5inf/uprog2/hw/housing/variant a/uprog2 Housing.png

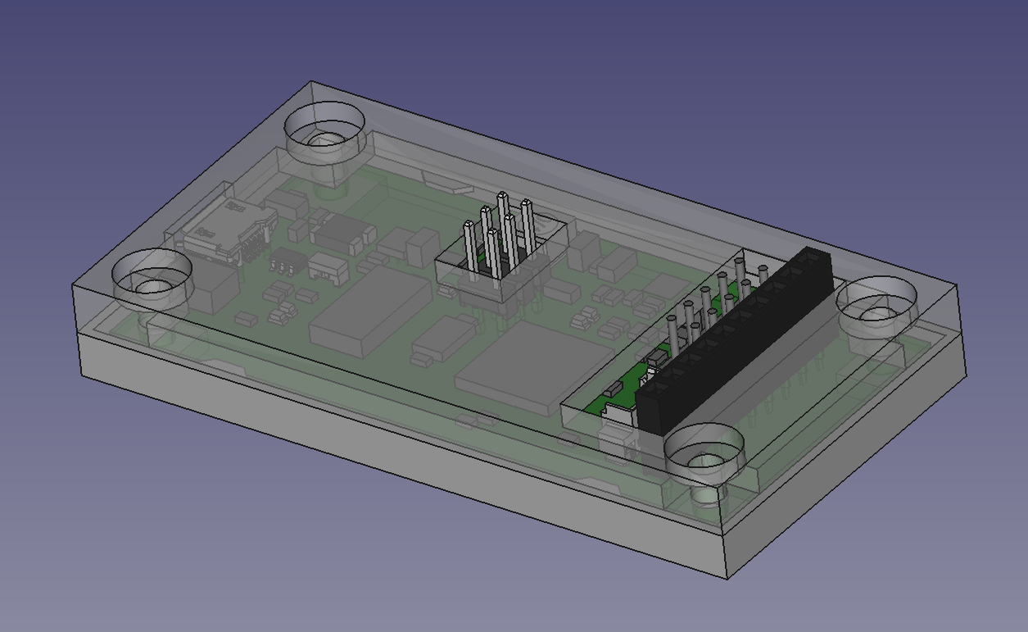
hw/housing/variant a/uprog2 Housing.png
