5inf/uprog2/hw/pcb/BOM.xlsx

uprog2.PrjPCB
BoardRevisionDate |  | 2019-02-20
BoardRevisionNumber |  | 0.0.0
# | Designator | Value | Description | Footprint | Quantity | Manufacturer | ManufacturerPartNumber
1 | C1, C8, C10 | X7R 25V 10% 100nF | CAP CER 1608[0603] X7R 10% 25V 100nF | Cap CER 1608[0603]L | 3 | not specifie | not specified
2 | C4, C5, C9 | X5R 50V 10% 1µF | CAP CER 1608[0603] X5R 10% 50V 1µF | Cap CER 1608[0603]L | 3 | not specified | not specified
3 | C12, C13 | C0G 25V 10% 15pF | CAP CER 1608[0603] C0G 10% 25V 15pF | Cap CER 1608[0603]L | 2 | not specified | not specified
4 | C14 | X7R 50V 10% 100nF | CAP CER 3216[1206] X7R 10% 50V 100nF | Cap CER 3216[1206]L | 1 | not specified | not specified
5 | D1 | 12A 5.0V | TVS Diode WE-TVS-HS, VRWM=5V | SOT23_5L | 1 | Würth | WE-TVS 824011
6 | D2 | 1mA 24V |  | SMB DO214AA | 1 | Bourns | SMBJ24CA
7 | D3, D5 | 500mA 40V |  | SOD123 | 2 | On Semi | MBR0540T1G
8 | F1 | 0.2A 30V | Polymeric PTC Resettable Fuse 30V 200mA Ih Surface Mount 1812 (4532 Metric), Concave | Fuse 4532[1812] | 1 | Littlefuse | 1812L020PR
9 | J1 | Molex PicoBlade 53398-0471 | 1.25mm Pitch PicoBlade™ Header, Surface Mount, Vertical, 4 Circuits | Connector 1.25mm 1x4 180° Molex PicoBlade 53398-0471 | 1 | Molex | 53398-0471
10 | JP3 | Multicomp Header - | Connector 2.54mm 2x3 180° Multicomp Header - | Connector 2.54mm 2x3 180° Multicomp Header - | 1 | Multicomp | -
11 | L1 | 18nH 2A 2A | SMD EMI Suppression Ferrite Beads WE-CBF, Z= 300 Ohm | 1608[0603]N | 1 | Würth | 742792641
12 | L2 | 90Z 370mA 370mA | SMD Common Mode Noise Suppressor WE-CNSW, Z= 90 Ohm | WE-CNSW, 1206 | 1 | Würth | 744232090
13 | LED1, LED4 | green 2.0V 20mA | LED 1608[0603] 180° green 2.0V 20mA Liteon LTST-C190KGKT | LED 1608[0603] 180° | 2 | Liteon | LTST-C190KGKT
14 | LED2, LED6 | red 2.0V 20mA | LED 1608[0603] 180° red 2.0V 20mA Liteon LTST-C190KRKT | LED 1608[0603] 180° | 2 | Liteon | LTST-C190KRKT
15 | LED3, LED5 | orange 2.0V 20mA | LED 1608[0603] 180° orange 2.0V 20mA Liteon LTST-C190KFKT | LED 1608[0603] 180° | 2 | Liteon | LTST-C190KFKT
16 | Q2 | MMBF5485 | N-channel RF Amplifier | SOT23_N | 1 | ON Semi | MMBF5485
17 | Q4 | IRLML6402 | P-channel MOSFET, 65mOhm, -20V DS, 12V GS, 2.5Vop | SOT23_M | 1 | Infineon | IRLML6402
18 | R4, R14, R18 | 1% 75V 10k | Res R 1608[0603] 1% 75V 100mW 10k | Res1608[0603]L | 3 | not specified | not specified
19 | R5, R6, R7, R8, R15, R16, R21 | 1% 75V 1k | Res R 1608[0603] 1% 75V 100mW 1k | Res1608[0603]L | 7 | not specified | not specified
20 | R12 | 5% 75V 4.7k | Res R 1608[0603] 5% 75V 100mW 4.7k | Res1608[0603]L | 1 | not specified | not specified
21 | R17 | 5% 75V 4.7 | Res R 1608[0603] 5% 75V 100mW 4.7 | Res1608[0603]L | 1 | not specified | not specified
22 | R19, R20 | 5% 75V 2.2k | Res R 1608[0603] 5% 75V 100mW 2.2k | Res1608[0603]L | 2 | not specified | not specified
23 | R22 | 20% 75V 1M | Res R 1608[0603] 20% 75V 100mW 1M | Res1608[0603]L | 1 | not specified | not specified
24 | U1 | FT232RL | FT232R USB UART IC , SSOP-28, Reel | SSOP-28_N | 1 | FTDI | FT232RL
25 | U2 | ATMEGA644P-20AU | IC ATMEGA644P-20AU | TQFP44A_N | 1 | Microchip | ATMEGA644P-20AU
26 | U3 | LP38691SD-3.3NOPB | Linearregler 3,3V 500mA | WSON-N6 | 1 | TI | LP38691SD-3.3NOPB
27 | X2 | Würth Micro USB 2.0 Typ B 629 105136 821 | Connector Xmm 1x1 90° Würth Micro USB 2.0 Typ B 629 105136 821 | Connector Xmm 1x1 90° Würth Micro USB 2.0 Typ B 629 105136 821 | 1 | Würth | 629 105136 821
28 | Y1 | ABM3B-20.000MHZ-B2-T | ABM3B-20.000MHZ-B2-T - Quarz, 20 MHz, SMD, 5mm x 3.2mm, 50 ppm, 18 pF, 20 ppm, Baureihe ABM3B | Y5.0x3.2 | 1 | Abracon | ABM3B-20.000MHZ-B2-T
