5inf/uprog2/hw/housing/variant a/uprog2 Housing bottom.step

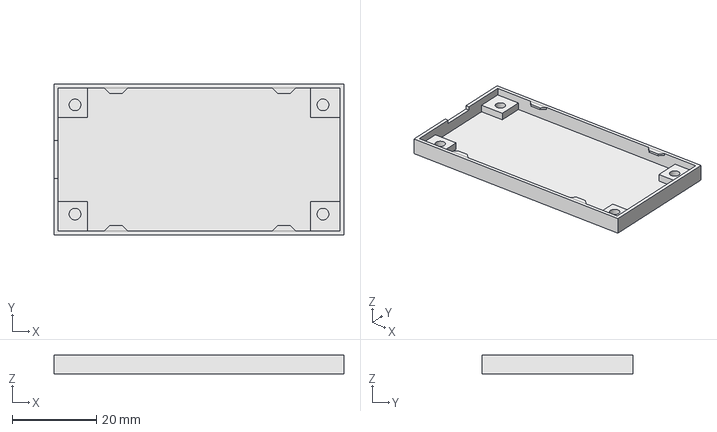
[picture p8: CAD file, 2019-07-19]
hw/housing/variant a/uprog2 Housing bottom.step
69.0 x 36.0 x 4.50 mm
