5inf/uprog2/hw/housing/variant b/uprog2.FCStd

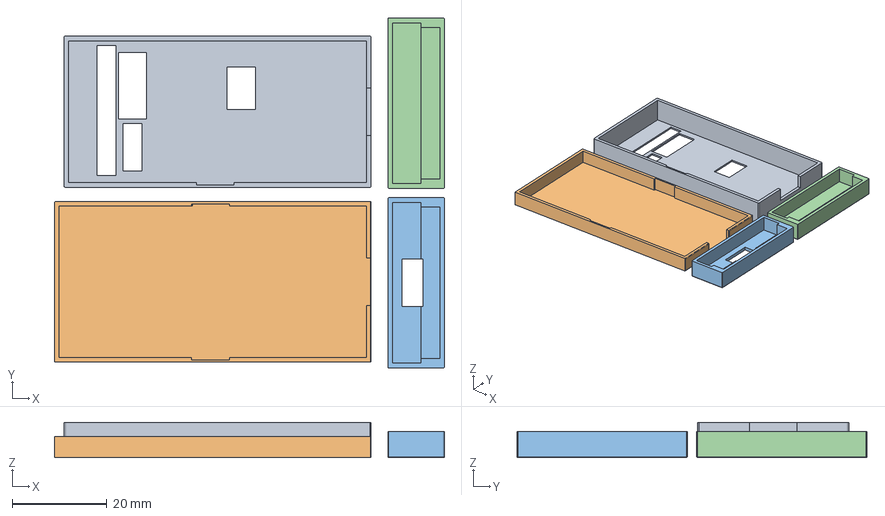
[picture p9: CAD file, 2019-07-22]
hw/housing/variant b/uprog2.FCStd
82.5 x 74.0 x 7.50 mm
