5inf/uprog2/hw/housing/variant a/uprog2 Housing top.step

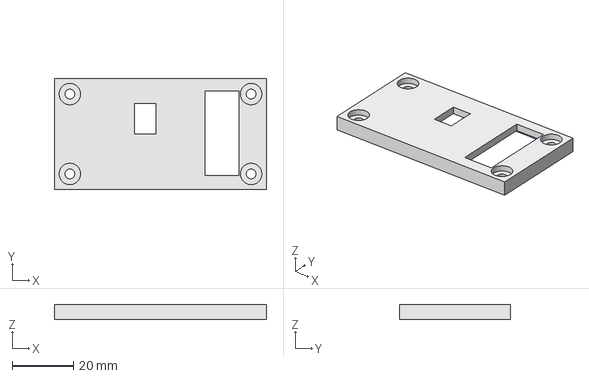
[picture p10: CAD file, 2019-07-19]
hw/housing/variant a/uprog2 Housing top.step
69.0 x 36.0 x 5.00 mm
