5inf/uprog2/(list of files, cad)

Other CAD files:
hw/housing/variant a/uprog2 Housing bottom.stl
hw/housing/variant a/uprog2 Housing top.stl
hw/housing/variant b/uprog2.stl
