5inf/uprog2/hw/pcb/uprog2.pdf

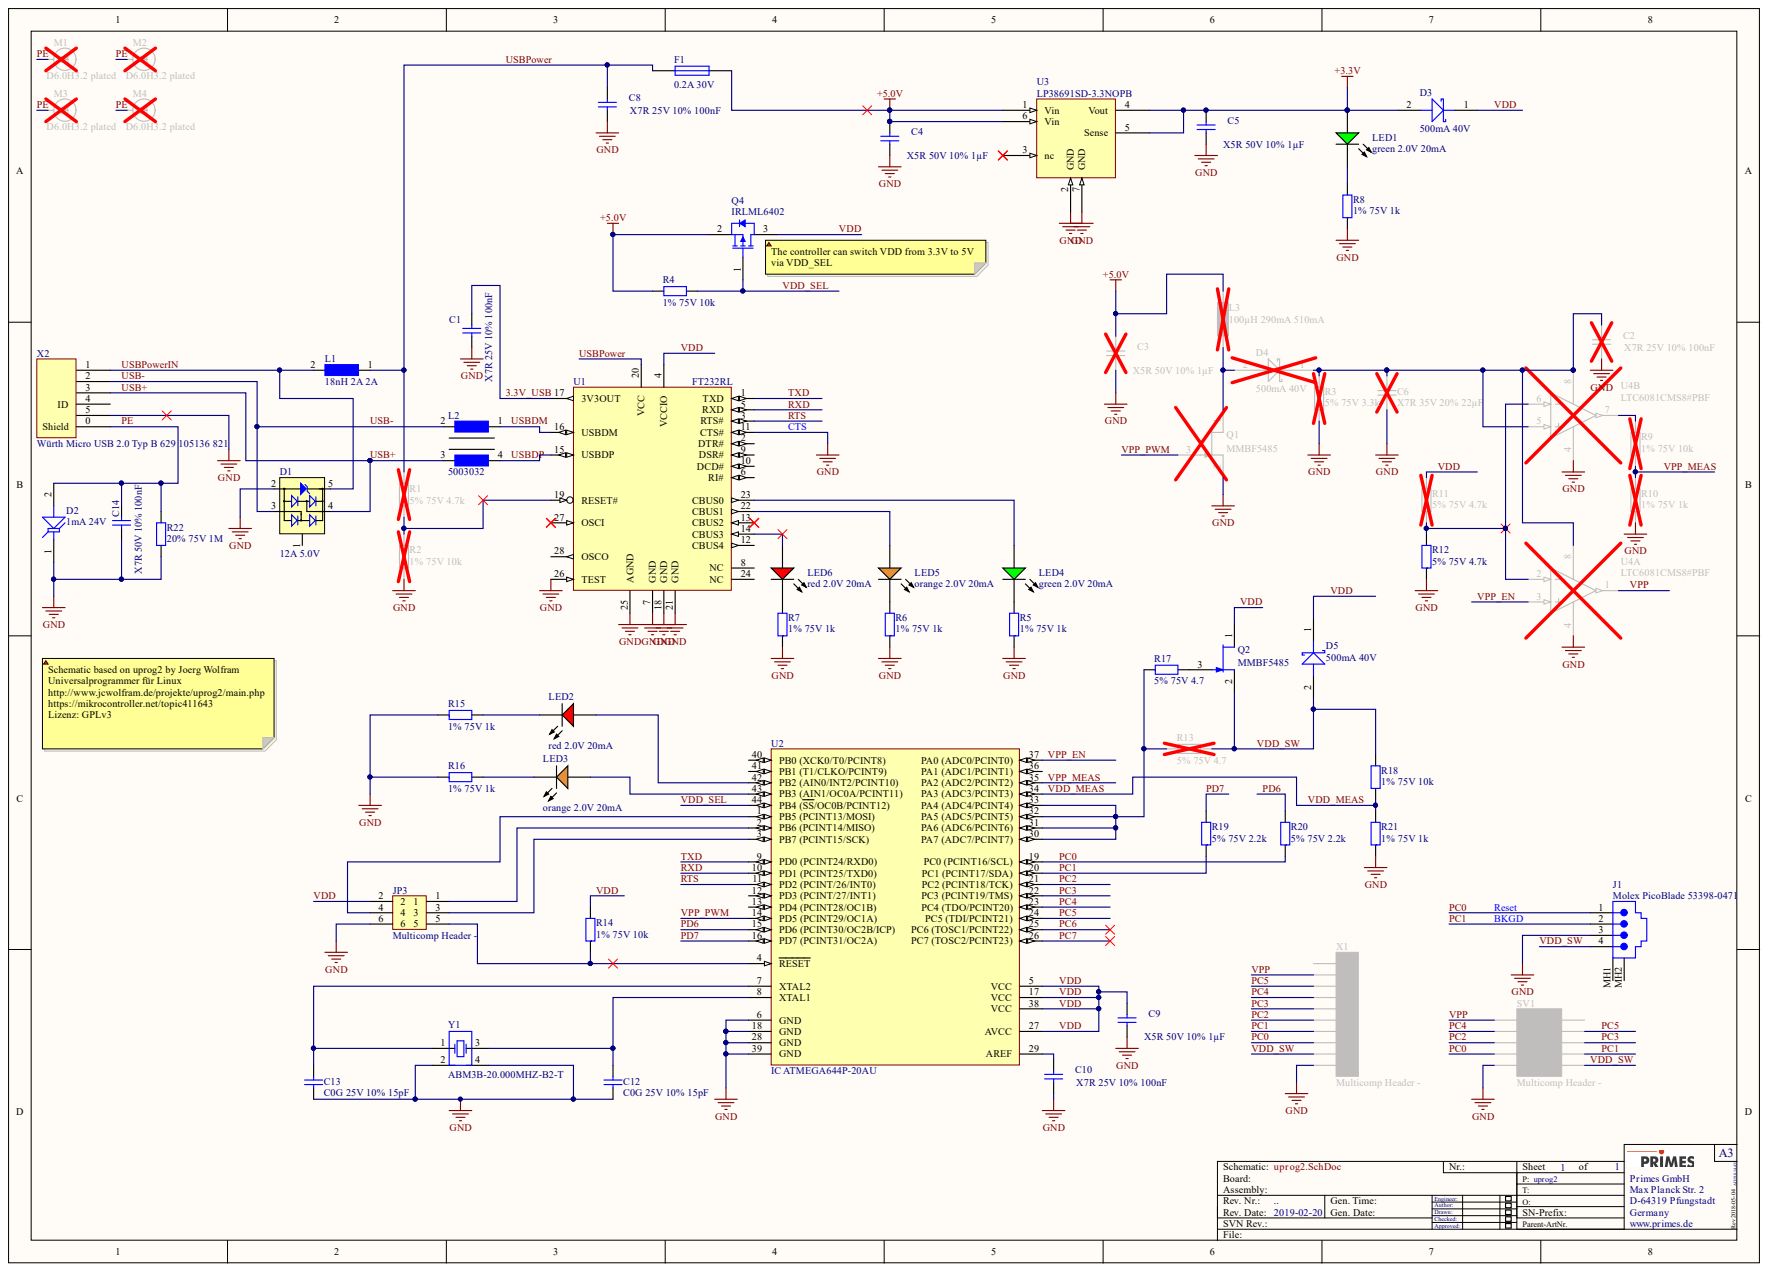
[picture p11: page 1]

The controller can switch VDD from 3.3V to 5V
via VDD_SEL

Würth Micro USB 2.0 Typ B 629 105136 821

Schematic based on uprog2 by Joerg Wolfram
Universalprogrammer für Linux
http://www.jcwolfram.de/projekte/uprog2/main.php
https://mikrocontroller.net/topic411643
Lizenz: GPLv3
