5inf/uprog2/(commit log)

2019-07-19 initial commit based on v1.33.
    [BOM.xlsx, uprog2 Housing bottom.step, uprog2 Housing top.step]
2019-07-19 Update README.md to include supported devices.
2019-07-19 Add second, improved variant of housing.
    [uprog2 Housing bottom.step, uprog2 Housing top.step, uprog2.FCStd, uprog2.stl]
2019-07-19 add STF files for housing and add gitignore.
    [uprog2 Housing bottom.stl, uprog2 Housing top.stl, uprog2.FCStd]
2019-07-20 Document fix for avra assembler.
2019-07-22 Add cutout for J1
    [uprog2.FCStd, uprog2.stl]
2019-10-29 Change USB VID and PID. Return correct error codes on exit.
    [main.c]
2022-10-06 Correct fuse values in Readme
2022-10-07 Update Readme.md for working with 1.42
    Working assembly for the adapter device.
    More details concerning changing the FTDI device PID and VID.
2022-10-07 Readme: Add verify to uprog2 device programming
