5inf/uprog2/(notices)

Notices in the files:
source/HOST/src/algorithm/algo_stm32f3.c:
copyright (c) 2012-2022 Joerg Wolfram (joerg@jcwolfram.de)
source/HOST/src/algorithm/algo_spiflash.c:
copyright (c) 2012-2020 Joerg Wolfram (joerg@jcwolfram.de)
source/HOST/src/main.c:
copyright (c) 2010-2022 Joerg Wolfram (joerg@jcwolfram.de)
source/HOST/src/algorithm/algo_rl78.c:
copyright (c) 2010-2015 Joerg Wolfram (joerg@jcwolfram.de)
source/HOST/src/algorithm/algo_s32k.c:
copyright (c) 2012-2021 Joerg Wolfram (joerg@jcwolfram.de)
